modulove/A-RYTH-MATIK/HAGIWO_Schematic.png

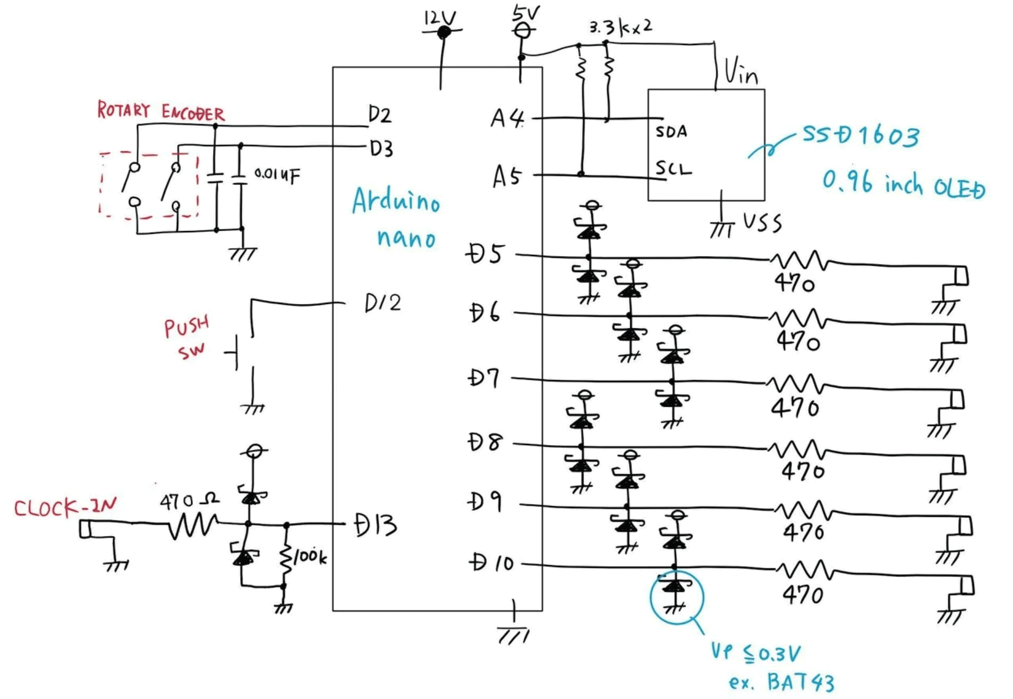
HAGIWO_Schematic.png
