modulove/A-RYTH-MATIK/(threads)

Thread 10 (2024-04-26):

GitHub Actions make fw

modulove, 2024-04-26:
We should finally make the move to github actions building the fw variants.
The firmware needs be compiled & uploaded manually all the time which is time consuming and error prone.

awonak, 2024-04-27:
I have applied this technique to my repository, here is how it works:

I'm my repository I use GitHub Actions to compile each of my firmwares with as set of 3 different flags to build binaries for each of the common Arduino Nano clones.

This action is triggered when a new tag is pushed with the semantic version pattern, like "vX.Y.Z". After the binaries are created, a new GitHub release is added and all of the firmware binaries are attached to the release.

https://github.com/awonak/HagiwoModulove/blob/main/.github/workflows/build_release.yml

The one unknown I have is how to automatically attach the new binary versions with your web based firmware uploader page. The best solution I can think of would be to update the `arduino-web-uploader` code to support serving binaries directly from the GitHub releases "latest" page. Otherwise they will likely need to be manually copied to the web uploader site.

modulove, 2024-04-28:
I think we move to github Page and I will give it a try to make it work after the current changes went into main. This will need to wait until superbooth is over i guess.

modulove, 2024-05-08:
Got this started here: https://github.com/modulove/modulove.github.io/blob/main/.github/workflows/build_release.yml
The hugo page and making a beta release available for testers, will take some time still .

Thread 15 (2024-05-24):

Check hardware support for LGT8F type arduino nano clone boards

modulove, 2024-05-24:
Boards based on LGT8F, e.g LGT8F328P (purple pcb) have some advanced features which are not covered in the code yet.

- 1. LGT8F328P allows you to increase the ADC resolution to 11 or 12 bits:

`void setup(){
    analogReference(INTERNAL4V096);
    analogReadResolution(10); // Resolution = 10, 11 or 12 Bit
}`

- Accuracy of the DAC
- LGT8F328P has two 8-bit and two 16-bit timers, so one 16-bit timer more (Timer3) than the ATmega328P
- 80 mA outputs (pins TX,  D2, D5 and D6 can supply up to 80 mA)
- Fastio – Functions (Similar to FastGPIO library, small, efficient)
-  You can set the Timer0 and Timer1 counter to double the system frequency, i.e. up to 64 MHz!

We should think about if we want to use this or abandon the support entirely I think.

modulove, 2024-07-14:
We do Set the amount of savestate slots, presets and Also if the bootlogo should Show depending on the microcontroller soon with futurebeat Update. This is a Start.

modulove, 2024-10-14:
LGT8F328P is no longer supported. We had some issues with briked devices.

Closed 2024-10-14.

Thread 16 (2024-05-25):

Support HAGIWO Sequencer clones HW?

modulove, 2024-05-25:
There are several (old and new) designs out there that I eventually like to support. Like the first design we tinkered with (https://github.com/Testbild-synth/Hagiwo_009_030_sequencer) and which where the initial reason the ARYTHMATIK exists.

- https://github.com/mzuelch/CATs-Eurosynth/tree/main/Modules/HAGIWO/6Ch%20Trigger%20Sequencer
- https://github.com/olonguet/HAGIWO-Sequencer
- https://github.com/Testbild-synth/Hagiwo_009_030_sequencer

I think we would need just the pinout of these Designs and could make this fw work on these. Does this make sense ?

Please post the Designs you know of, there at least two other Designs that I can't find the Link right now.

modulove, 2024-10-14:
Three is also "Dots" https://github.com/johannesstrueber/dots

dtk1985, 2025-01-10:
Since today I use Testbild's PCB with your polished A-RYTH-MATIK firmware 😊 That build does not have Reset input and LEDs for the gate outputs but works great anyway. Only thing I did is swapped the rotary encoder's 2 pin numbers in the code because that was going the other way.

modulove, 2025-01-12:
> Since today I use Testbild's PCB with your polished A-RYTH-MATIK firmware 😊 That build does not have Reset input and LEDs for the gate outputs but works great anyway. Only thing I did is swapped the rotary encoder's 2 pin numbers in the code because that was going the other way.

Thanks for reporting! Good to know it's working on this one :)

Closed 2025-01-12.
