modulove/A-RYTH-MATIK/BOM/A_RYTH_MATIK_REV_1_BOM_v2.pdf

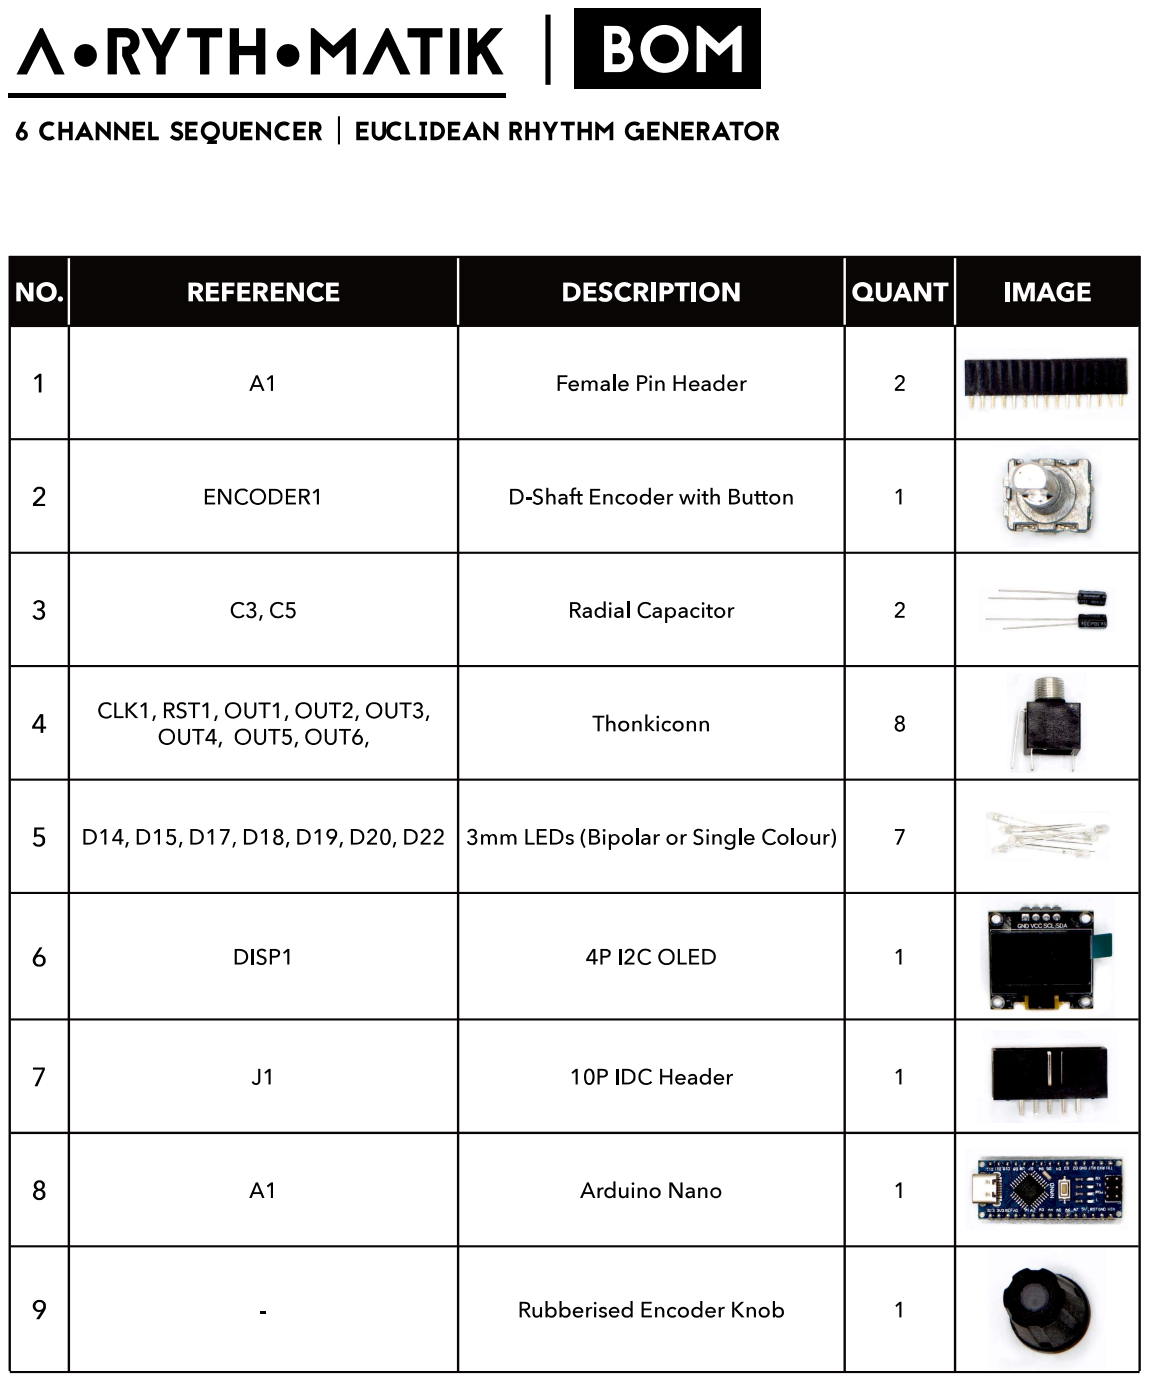
[picture p5: page 1]
