modulove/A-RYTH-MATIK/Firmware/ARYTHMATIK_Labor/ARYTHMATIK_Labor.ino

#include "src/libmodulove/arythmatik.h"
#include <avr/pgmspace.h>
#include <FastGPIO.h>

// Configuration flags
//#define ENCODER_REVERSED
//#define ROTATE_PANEL
//#define DISABLE_BOOT_LOGO

#ifdef ROTATE_PANEL
// When panel is rotated
#define RESET FastGPIO::Pin<13>
#define CLK FastGPIO::Pin<11>
#define OUTPUT1 FastGPIO::Pin<8>
#define OUTPUT2 FastGPIO::Pin<9>
#define OUTPUT3 FastGPIO::Pin<10>
#define OUTPUT4 FastGPIO::Pin<5>
#define OUTPUT5 FastGPIO::Pin<6>
#define OUTPUT6 FastGPIO::Pin<7>
#define LED1 FastGPIO::Pin<0>
#define LED2 FastGPIO::Pin<1>
#define LED3 FastGPIO::Pin<17>
#define LED4 FastGPIO::Pin<14>
#define LED5 FastGPIO::Pin<15>
#define LED6 FastGPIO::Pin<16>
#else
// When panel is not rotated
#define RESET FastGPIO::Pin<11>
#define CLK FastGPIO::Pin<13>
#define OUTPUT1 FastGPIO::Pin<5>
#define OUTPUT2 FastGPIO::Pin<6>
#define OUTPUT3 FastGPIO::Pin<7>
#define OUTPUT4 FastGPIO::Pin<8>
#define OUTPUT5 FastGPIO::Pin<9>
#define OUTPUT6 FastGPIO::Pin<10>
#define LED1 FastGPIO::Pin<14>
#define LED2 FastGPIO::Pin<15>
#define LED3 FastGPIO::Pin<16>
#define LED4 FastGPIO::Pin<0>
#define LED5 FastGPIO::Pin<1>
#define LED6 FastGPIO::Pin<17>
#endif
#define CLK_LED FastGPIO::Pin<4>

using namespace modulove;
using namespace arythmatik;

Arythmatik hw;

int framecount1 = 0;
int framecount2 = 3;  // Offset the second animation by 3 frames
int hammerCycle = 0;          // Track the number of cycles
bool hammerState = false;
unsigned long lastClockTime = 0;
bool useInternalClock = false;
bool toggleState = false;   // Track the toggle state

// 'frame_00_delay-0', 46x60px
const unsigned char labour00 [] PROGMEM = {
	0x00, 0x00, 0x00, 0x00, 0x00, 0x00, 0x00, 0x00, 0x00, 0x00, 0x00, 0x00, 0x00, 0x00, 0x00, 0x02, 
	0x00, 0x00, 0x00, 0x00, 0x00, 0x04, 0x00, 0x00, 0x00, 0x00, 0x00, 0x00, 0x00, 0x00, 0x00, 0x00, 
	0x00, 0x00, 0x00, 0x00, 0x00, 0x00, 0x00, 0x00, 0x00, 0x00, 0x00, 0x00, 0x00, 0x00, 0x00, 0x00, 
	0x00, 0x00, 0x00, 0x20, 0x00, 0x00, 0x00, 0x00, 0x00, 0x20, 0x00, 0x00, 0x00, 0x00, 0x00, 0x60, 
	0x00, 0x00, 0x00, 0x00, 0x00, 0x70, 0x00, 0x00, 0x00, 0x00, 0x00, 0x3c, 0x00, 0x00, 0x00, 0x00, 
	0x00, 0x1e, 0x00, 0x00, 0x00, 0x00, 0x00, 0x1f, 0x00, 0x00, 0x00, 0x00, 0x00, 0x01, 0x0c, 0x00, 
	0x00, 0x0e, 0x00, 0x01, 0x1e, 0x00, 0x00, 0x1e, 0x00, 0x01, 0xbf, 0x00, 0x00, 0x7c, 0x00, 0x01, 
	0xff, 0x80, 0x01, 0xfc, 0x00, 0x01, 0xff, 0x80, 0x03, 0xfc, 0x00, 0x01, 0xff, 0x80, 0x07, 0xfc, 
	0x00, 0x01, 0xff, 0xc0, 0x0f, 0xfc, 0x00, 0x01, 0xfd, 0xc0, 0x0f, 0xec, 0x00, 0x01, 0xfd, 0xc0, 
	0x0f, 0xec, 0x00, 0x01, 0xfc, 0xc0, 0x0f, 0xee, 0x00, 0x01, 0xfc, 0xc0, 0x0f, 0xee, 0x00, 0x01, 
	0xfd, 0xc0, 0x0f, 0xe7, 0x00, 0x01, 0xf9, 0xc0, 0x0f, 0xe7, 0x00, 0x00, 0xf9, 0x80, 0x1f, 0xe1, 
	0x80, 0x00, 0x01, 0x00, 0x3f, 0xe0, 0x80, 0x10, 0x03, 0x00, 0x3f, 0xf0, 0x40, 0x10, 0x07, 0x00, 
	0x3f, 0xfc, 0xf3, 0x02, 0x0f, 0x00, 0x3f, 0xc7, 0x38, 0x02, 0x07, 0x00, 0x3f, 0xc0, 0x00, 0x0b, 
	0x07, 0x00, 0x1f, 0xc0, 0x00, 0x03, 0x07, 0x00, 0x07, 0xe0, 0x00, 0x00, 0x0f, 0x00, 0x07, 0xe0, 
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
	0xc7, 0x80, 0x1f, 0xc0, 0x00, 0x00, 0xcf, 0x80, 0x1f, 0xc0, 0x00, 0x00, 0xc7, 0x80, 0x0f, 0xc0, 
	0x00, 0x00, 0xc7, 0x80, 0x0f, 0xe0, 0x00, 0x00, 0xc7, 0x00, 0x0f, 0xe0, 0x00, 0x04, 0xe7, 0x00, 
	0x0f, 0xe0, 0x00, 0x06, 0x23, 0x00, 0x07, 0xf0, 0x00, 0x07, 0x13, 0x00, 0x07, 0xf0, 0x00, 0x0f, 
	0x93, 0x80, 0x07, 0xe0, 0x00, 0x0f, 0x93, 0x80, 0x07, 0xe0, 0x03, 0xff, 0x9b, 0x80, 0x07, 0xe0, 
	0x00, 0xff, 0x93, 0x80, 0x0f, 0xe0, 0x00, 0xff, 0x93, 0x80, 0x0e, 0x60, 0x00, 0xff, 0x81, 0x80, 
	0x0e, 0x60, 0x00, 0x7f, 0x81, 0x80, 0x0e, 0xc0, 0x00, 0x3f, 0x81, 0x80, 0x0e, 0x40, 0x00, 0x3f, 
	0x99, 0x80, 0x04, 0x40, 0x00, 0x1f, 0x99, 0x80, 0x04, 0x40, 0x00, 0x1f, 0xf9, 0x80, 0x64, 0xe0, 
	0x00, 0x1f, 0xff, 0x80, 0xf7, 0xff, 0xf8, 0x1f, 0xff, 0xfc, 0xef, 0xff, 0xfc, 0x1f, 0xff, 0xfc, 
	0xff, 0xff, 0xff, 0xff, 0xff, 0xfc, 0xff, 0xff, 0xff, 0xff, 0xff, 0xfc, 0xff, 0xff, 0xff, 0xff, 
	0xff, 0xfc, 0xff, 0xff, 0xff, 0xff, 0xff, 0xfc
};


// Array of all bitmaps for convenience. (Total bytes used to store images in PROGMEM = 4608)
const int labours_LEN = 12;
const unsigned char* labours[12] = {
	labour00,
	labour01,
	labour02,
	labour03,
	labour04,
	labour05,
	labour06,
	labour07,
	labour08,
	labour09,
	labour10,
	labour11
};

// smaller 'Modulove_Logo', 28x32px to save resources
const unsigned char Modulove_Logo[] PROGMEM = {
  0x00, 0x00, 0x00, 0x00, 0x03, 0xf0, 0x00, 0x00, 0x0c, 0x18, 0x7e, 0x00, 0x18, 0x05, 0x81, 0x80,
  0x10, 0x07, 0x00, 0xc0, 0x20, 0x06, 0x00, 0x40, 0x20, 0x05, 0x00, 0x20, 0x42, 0x09, 0x00, 0x20,
  0x42, 0x09, 0x00, 0x20, 0x41, 0x09, 0x01, 0x20, 0x41, 0x89, 0x02, 0x20, 0x40, 0x87, 0x0c, 0x20,
  0x20, 0xc7, 0x0c, 0x20, 0x20, 0x7d, 0xf0, 0x40, 0x10, 0x00, 0x00, 0x40, 0x10, 0x00, 0x00, 0x80,
  0x08, 0x00, 0x01, 0x80, 0x04, 0x00, 0x01, 0x00, 0x02, 0x00, 0x02, 0x00, 0x01, 0x00, 0x04, 0x00,
  0x00, 0xc0, 0x0c, 0x00, 0x00, 0x60, 0x10, 0x00, 0x00, 0x30, 0x20, 0x00, 0x00, 0x08, 0x40, 0x00,
  0x00, 0x04, 0x80, 0x00, 0x00, 0x03, 0x00, 0x00, 0x00, 0x03, 0x80, 0x00, 0x00, 0x04, 0x80, 0x00,
  0x00, 0x04, 0x40, 0x00, 0x00, 0x04, 0x40, 0x00, 0x00, 0x06, 0xc0, 0x00, 0x00, 0x03, 0x80, 0x00
};


void setup() {
#ifdef ROTATE_PANEL
  hw.config.RotatePanel = false;
#endif
#ifdef REVERSE_ENCODER
  hw.config.ReverseEncoder = true;
#endif

    hw.Init();

    // boot logo animation only on nano for now
#if !defined(LGT8FX_BOARD) && !defined(DISABLE_BOOT_LOGO)
  drawAnimation();
  delay(1200);
#endif


    delay(1200);

    hw.display.clearDisplay();
    hw.display.setTextColor(WHITE);
    hw.display.setCursor(18, 20);
    hw.display.print("Nude Blacksmith");
    hw.display.setCursor(12, 35);
    hw.display.setTextSize(1);
    hw.display.print("Hammering Sequence");
    hw.display.display();

    delay(2000);

    hw.display.clearDisplay();
    hw.display.setTextColor(WHITE);
    hw.display.setCursor(16, 20);
    hw.display.print("Happy Labourday");
    hw.display.setCursor(10, 35);
    hw.display.setTextSize(1);
    hw.display.print("Patch: Omri Cohen");
    hw.display.display();

    delay(2000);
}

void loop() {
    hw.ProcessInputs();

    bool rst = hw.rst.State() == DigitalInput::STATE_RISING;
    bool clk = hw.clk.State() == DigitalInput::STATE_RISING;

    // Reset sequence on reset input
    if (rst) {
        resetSeq();
    }

    // Check for clock pulse and update the lastClockTime
    if (clk) {
        lastClockTime = millis();
        useInternalClock = false;  // Use external clock
        advanceFrame();
    }

    // Check if 3 seconds have passed since the last clock pulse
    if (millis() - lastClockTime > 3000) {
        useInternalClock = true;  // Switch to internal clocking
    }

    // If using internal clock, advance the frame every 66ms for ~15fps
    if (useInternalClock) {
        static unsigned long lastInternalTime = 0;
        if (millis() - lastInternalTime > 66) {
            lastInternalTime = millis();
            advanceFrame();
        }
    }
}

void advanceFrame() {
    framecount1 = (framecount1 + 1) % labours_LEN;
    framecount2 = (framecount2 + 1) % labours_LEN;

    // Flip the toggle state every 4 frames
    if (framecount1 % 4 == 0) {
        toggleState = !toggleState;
    }

    hw.display.clearDisplay();
    hw.display.fillRect(0, 0, 128, 64, BLACK);

    // Randomly flip orientation and invert the image
    drawImageWithEffects(12, 0, labours[framecount1], toggleState);
    drawImageWithEffects(70, 0, labours[framecount2], !toggleState);

// Handle blacksmith hammering states
if (framecount1 == 1) {
    hw.outputs[0].High();   // First blacksmith hammers (output 0)
    hw.outputs[4].Low();    // Ensure second blacksmith is off (output 1)
} else if (framecount1 == 2) {
    hw.outputs[0].Low();    // Ensure first blacksmith is off (output 0)
    hw.outputs[4].High();   // Second blacksmith hammers (output 1)
} else {
    hw.outputs[0].Low();    // Turn off first blacksmith (output 0)
    hw.outputs[4].Low();    // Turn off second blacksmith (output 1)
}

// Handle blacksmith hammering states for the right animation (outputs 3 and 4)
if (framecount2 == 1) {
    hw.outputs[3].High();   // First blacksmith hammers (output 3)
    hw.outputs[1].Low();    // Ensure second blacksmith is off (output 4)
} else if (framecount2 == 2) {
    hw.outputs[3].Low();    // Ensure first blacksmith is off (output 3)
    hw.outputs[1].High();   // Second blacksmith hammers (output 4)
} else {
    hw.outputs[3].Low();    // Turn off first blacksmith (output 3)
    hw.outputs[1].Low();    // Turn off second blacksmith (output 4)
}

    // Toggle outputs 3 and 6 when framecount1 or framecount2 reaches 6
       if (framecount1 == 6 || framecount2 == 3) {
        hw.outputs[2].High();
        hw.outputs[5].Low();
    } else {
        hw.outputs[2].Low();
        hw.outputs[5].High();
    }

    hw.display.display();
}

void drawImageWithEffects(int x, int y, const unsigned char* bitmap, bool invert) {
    if (invert) {
        hw.display.drawBitmap(x, y, bitmap, 46, 60, BLACK);
        hw.display.drawBitmap(x, y, bitmap, 46, 60, WHITE);
    } else {
        hw.display.drawBitmap(x, y, bitmap, 46, 60, WHITE);
    }
}

void drawAnimation() {
    hw.display.fillRect(0, 0, 128, 64, BLACK);
    hw.display.drawBitmap(50, 16, Modulove_Logo, 28, 32, WHITE);
    hw.display.display();
}

void resetSeq() {
    framecount1 = 0;
    framecount2 = 3;  // Reset with the offset
    hw.outputs[0].Low();
    hw.outputs[1].Low();
    hw.outputs[2].Low();
    hw.outputs[3].Low();
    hw.outputs[4].Low();
    hw.outputs[5].Low();
}
