modulove/A-RYTH-MATIK/(commit log)

2023-02-15 Add bom
    [A_RHYTH_MATIK_REV_1_bom.csv]
2023-02-15 change bom
    [A_RHYTH_MATIK_REV_1_bom.csv]
2023-02-15 fix bom
    [A_RHYTH_MATIK_REV_1_bom.csv]
2023-02-15 fix bom again
    [A_RHYTH_MATIK_REV_1_bom.csv]
2023-02-15 Add BOM as PDF
2023-03-13 Add ENCODER_COUNT_PER_CLICK config option
    should make it work different encoder types
2023-03-21 Add BOMv2 PDF
    new version BOM
2023-03-25 Slimline BOM
    Remove already placed components for clarity.
    [A_RHYTH_MATIK_REV_1_bom.csv]
2023-07-20 Fix typo in GPIO pins. Add RST_PIN, test CLK pin & led.
2023-10-29 Add Schematic
2023-11-05 Delete Schematic.png
    There is an error that needs to be fixed
2024-02-09 Update ARYTHMATIK_Gate-seq.ino
    Add missing reset (in11) in.
    [ARYTHMATIK_Gate-seq.ino]
2024-02-10 Update ARYTHMATIK_Gate-seq.ino
    First crack at optimizing.
    [ARYTHMATIK_Gate-seq.ino]
2024-04-23 Update ARYTHMATIK_Euclid.ino
    flip display again
    [ARYTHMATIK_Euclid.ino]
2024-04-23 Fix savestate ARYTHMATIK_Euclid.ino
    Cleaned up some mess.
    Lots of in there still
    [ARYTHMATIK_Euclid.ino]
2024-04-24 Update ARYTHMATIK_Euclid.ino
    Fixes for menue & some more cleanup.
    [ARYTHMATIK_Euclid.ino]
2024-04-24 Update ARYTHMATIK_Euclid.ino
    Fixed Menue
    New Quick access Menue (rotate encoder CCW) with Toggle Mute
    [ARYTHMATIK_Euclid.ino]
2024-04-24 Update A_RHYTH_MATIK_REV_1_bom.csv
    Add some more Info
    [A_RHYTH_MATIK_REV_1_bom.csv]
2024-04-26 Update ARYTHMATIK_Euclid.ino
    Add UPSIDEDOWN define for the new flip-panel
    [ARYTHMATIK_Euclid.ino]
2024-04-26 Update ARYTHMATIK_Euclid.ino
    Whooops. CLK in & RST need to be switched as well.
2024-04-30 Update ARYTHMATIK_Euclid.ino
    prepare for ENCODER_REVERSED
2024-04-30 Update ARYTHMATIK_Gate-seq.ino
    ENCODER_REVERSED & PANEL_USD
2024-04-30 Update ARYTHMATIK_Euclid.ino
    ifdef ENCODER_REVERSED instead of #ifdef INVERTED
    [ARYTHMATIK_Euclid.ino]
2024-04-30 Update ARYTHMATIK_Euclid.ino
    test reverse encoder option
    [ARYTHMATIK_Euclid.ino]
2024-04-30 Update ARYTHMATIK_Gate-seq.ino
    Add reversed encoder option
    [ARYTHMATIK_Gate-seq.ino]
2024-04-30 Update ARYTHMATIK_Gate-seq.ino
    reverse default direction to (CW)
    [ARYTHMATIK_Gate-seq.ino]
2024-04-30 Update ARYTHMATIK_DEBUG.ino
    correct default direction for DEBUG fw
    [ARYTHMATIK_DEBUG.ino]
2024-05-01 Update ARYTHMATIK_Euclid.ino
    Housekeeping comments, config, few small fixes.
    This should make the code a little more readable in some places.
    Will have another take on the remaining changes soon.
    [ARYTHMATIK_Euclid.ino]
2024-05-03 Update README.md
    Add BOM html preview Link
2024-05-05 Update ARYTHMATIK_Euclid.ino
    Running into some issues here so keep commits small.
    Changed flip Panel defines.
    Added loading default settings (WIP)
    [ARYTHMATIK_Euclid.ino]
2024-05-08 Update ARYTHMATIK_Euclid.ino
    Reintroduce bar_select manipulation in random mode allowing adjustment with rotary encoder.
2024-05-13 Update ARYTHMATIK_Euclid.ino
    Replaced SimpleRotary with EncoderButton
    Added probability & UI
    More small UI changes
    [ARYTHMATIK_Euclid.ino]
2024-05-13 Update ARYTHMATIK_Euclid.ino
    test encoder acceleration
    some more smaller fixes
    [ARYTHMATIK_Euclid.ino]
2024-05-14 Update ARYTHMATIK_Euclid.ino
    Added onEncoderPressedRotation (Long button press) for the ability to quickly dial in Hits from the first level of the menue (Select channel) while the button is pressed.
2024-05-14 Update ARYTHMATIK_Euclid.ino
    Fix Random_change() so it advances the channels with encoder rotation.
    [ARYTHMATIK_Euclid.ino]
2024-05-14 Update ARYTHMATIK_Euclid.ino
    Fix initializeCurrentConfig
    [ARYTHMATIK_Euclid.ino]
2024-05-14 Update ARYTHMATIK_Euclid.ino
    Rework channel & select menu to make it more readable. looks pretty ok to me. in depth testing needed still
    [ARYTHMATIK_Euclid.ino]
2024-05-22 Update ARYTHMATIK_Euclid.ino
    reversed the logic of offset so it rotates in the right direction
    [ARYTHMATIK_Euclid.ino]
2024-05-22 Turn off clock LED
    Turn off clock LED along with the output pins after a delay of 10 milliseconds.
2024-05-23 RandomAdvance & Random X mode
    Make these work again while holding button & rotating Encoder
2024-05-23 ARYTHMATIK_Euclid.ino - More cleanup and fixes
    Select EEPROM Slot with held encoder (WIP)
    Several performance improvements
    [ARYTHMATIK_Euclid.ino]
2024-05-23 ARYTHMATIK_Euclid.ino - (onEncoderPressedRotation) select channel in Channel edit modes
    encoder's pressed rotation can now select the channel when editing Channel settings (Hits,Offset,Limit,Mute,Random,Prob). Making the UI more intuitive and functional.
2024-05-24 ARYTHMATIK_Euclid.ino - some quick patches
    Updated default (preset) config for presets with names (WIP)
    Replaced TEMPO with PRESET menu (Internal Clock later)
    [ARYTHMATIK_Euclid.ino]
2024-05-26 Fixed behavior for showing menu overlay during encoder press and hold for advanced global settings like Save, Load, and Preset.
    [ARYTHMATIK_Euclid.ino]
2024-05-27 This will update how the UI Refresh behavior works:
    When clock running, refresh on:
    - clock input
    - reset input
    - encoder press / release
    - NOT on encoder rotate (one of the above must happen to update UI)
    When not running, refresh on:
    - any of the events above
    - after 1 second (a half note at 120bpm), UI constantly updates
    [ARYTHMATIK_Euclid.ino]
2024-05-27 Fixed index bug causing all channesl to follow ch 1.
    [ARYTHMATIK_Euclid.ino]
2024-05-29 ARYTHMATIK_Euclid.ino - load the latest saved state on boot
    Load the latest saved state on boot and save the last slot used to EEPROM
2024-05-30 Allow encoder to refresh the display with a throttled min refresh rate.
2024-06-02 fixed bug in logic. allows even faster ui refresh rate.
    [ARYTHMATIK_Euclid.ino]
2024-06-04 Mostly code cleanup, no decent performance improvements yet. * Consistent side menu drawing functions. * Fully separate the unique Probability screen from the Euclid Pattern screen * Replace F() stri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
    [ARYTHMATIK_Euclid.ino]
2024-06-07 Fixed logic bug in display refresh rate.
    [ARYTHMATIK_Euclid.ino]
2024-06-08 encoder.setRateLimit(20);
    This was needed for me to make it not skip ouptuts while using the encoder. Now works as discribed without missing here as well
    [ARYTHMATIK_Euclid.ino]
2024-06-08 increase min refresh duration
    100ms was still causing beats to skip, so I increased it up to 250ms and I can no longer detect any missed beats or wonky behavior.
    [ARYTHMATIK_Euclid.ino]
2024-06-11 ARYTHMATIK_Euclid.ino - Fix for toggle Mute & Don't mute when manually advancing in "X" Random mode
    Fix for toggle Mute function
    Don't mute when manually advancing in "X" Random mode
    [ARYTHMATIK_Euclid.ino]
2024-06-12 ARYTHMATIK_Euclid.ino - restore onEncoderPressedRotation & Fix external clock detection
    restore onEncoderPressedRotation for quick edit hits,offset,limit, .. while in edit modes
    - Fix clock detection so it switches between internal & clock input
    [ARYTHMATIK_Euclid.ino]
2024-06-12 ARYTHMATIK_Euclid.ino - Update onEncoderRotation
    Fix Bug with remove adjusting Hits in onEncoderRotation
    [ARYTHMATIK_Euclid.ino]
2024-06-12 ARYTHMATIK_Euclid.ino - Update onEncoderPressedRotation
    Use Random_change() and Random_change_mute() functions based on the encoder rotation direction while encoder button is pressed
2024-06-12 ARYTHMATIK_Euclid.ino - fix Display bug when only 1 hit is defined
    The hits line was mirrored when there is only 1 hit (Thanks Sasha)
    [ARYTHMATIK_Euclid.ino]
2024-06-13 Fixed a bug clock bug
    When internal clock mode active and an external clock was sent to CLK, the period would get double counted. Now we check clock input according to internalClock value.
    Also removed some dead code that was not executing (ch select happens in handleSettingNavigation).
    [ARYTHMATIK_Euclid.ino]
2024-06-26 Update ARYTHMATIK_Euclid.ino - few smaller fixes
    Refresh hits at boot time
    Combine Random change functions
    [ARYTHMATIK_Euclid.ino]
2024-06-27 Update ARYTHMATIK_Euclid.ino - Use encoderButton timeout
    Use encoderButton timeout
2024-06-27 Update ARYTHMATIK_Euclid.ino - Add LongClick Mute in TOP_MENU
    Now toggles mute status of the selected channel when in SETTING_TOP_MENU with long button push
2024-06-29 minor bug fixes; add missing encoder handler parameter, removed redundant disp_refresh set.
    [ARYTHMATIK_Euclid.ino]
2024-06-29 avoid multiple calls to OLED_display by making force_refresh a global.
    [ARYTHMATIK_Euclid.ino]
2024-06-29 fix setTextSize bug where preset remained 2, remove redundant setTextColor, minor readability fix.
    [ARYTHMATIK_Euclid.ino]
2024-07-10 Last minute changes
    Fix LGT8FX8P problem by limiting slots.
    Also preset array with conditional size
    Update rhythm patterns
    [ARYTHMATIK_Euclid.ino]
2024-07-14 Cosmetics ARYTHMATIK_Euclid.ino
    New menu order. loved this 💯
    Few UI tweaks.
2024-07-24 Fix bootlogo & nudge without acceleration
    Last chance for nudge feature fixed without acceleration?
    Boologo fix (no more artifacts)
    [ARYTHMATIK_Euclid.ino]
2024-07-24 some performance tweaks
    removes some artifacts
    removes random skips
    [ARYTHMATIK_Euclid.ino]
2024-07-28 Change Encoder overlay menu handling
    Long press loads / saves now
    Remove UI elements to fight artifacts
2024-08-03 final stretch updates
    encoder functions with switch statement
    update rythms
2024-09-03 Fix Reset input - ARYTHMATIK_Gate-seq.ino
    [ARYTHMATIK_Gate-seq.ino]
2024-10-13 Add back navigation feature - ARYTHMATIK_Euclid.ino
    Implement a back navigation feature using a long press on the encoder button that decrements the selected_menu when the user is within the parameter setting modes (Hits, Offset, Limit, Reset, Mute, or Probability)
    [ARYTHMATIK_Euclid.ino]
2025-07-15 Update ARYTHMATIK_Euclid.ino
    Adds pin change interrupt handling
